Makertech3D/Dual-Switching-Hotend-v1/README.md

# Dual-Switching-Extruder
Downloads and opensource files for the Dual Switching Extruder
