Makertech3D/Dual-Switching-Hotend-v1/DSE Insert.pdf

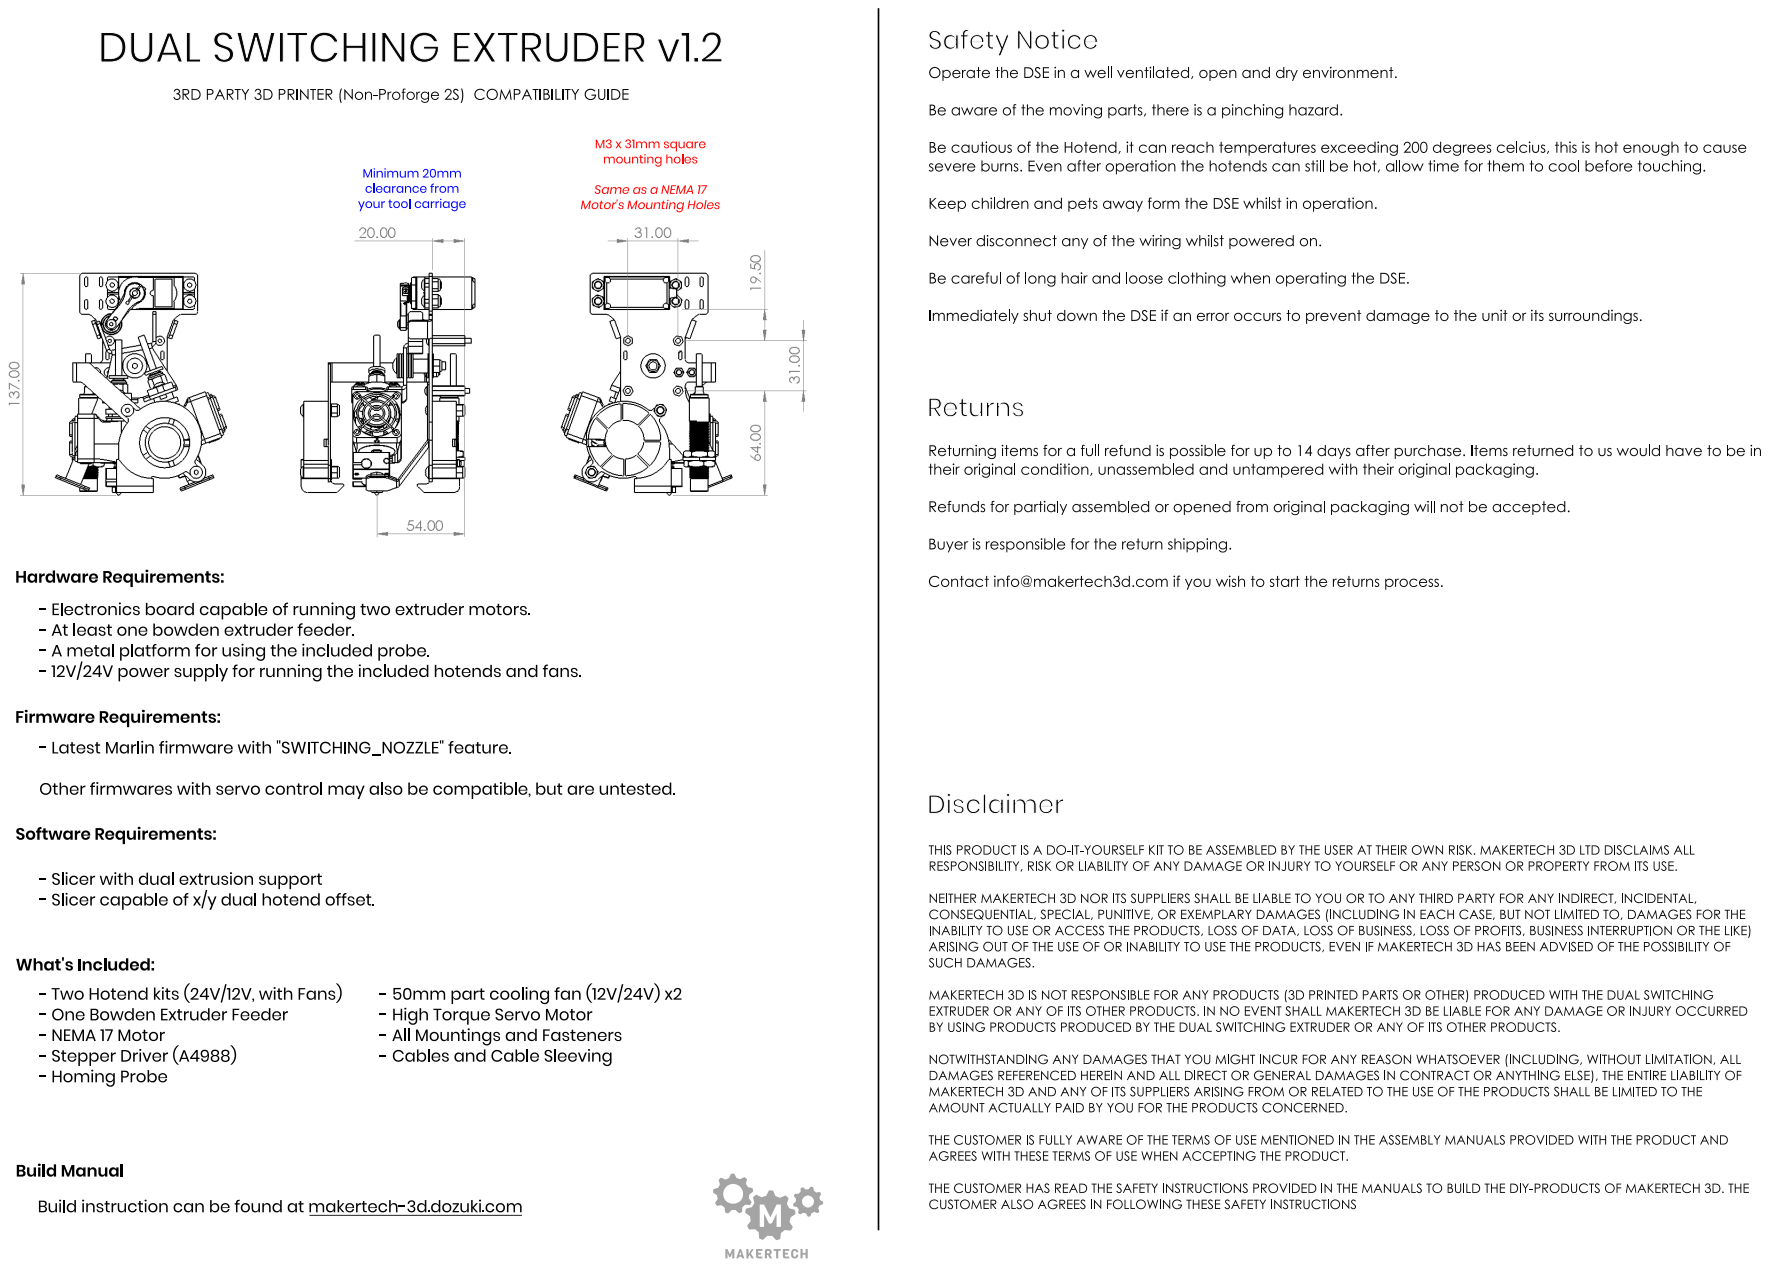
[picture p1: page 1]
