Makertech3D/Dual-Switching-Hotend-v1/3D Printed Parts/Fan Shroud Rear-Left (Raised).STL

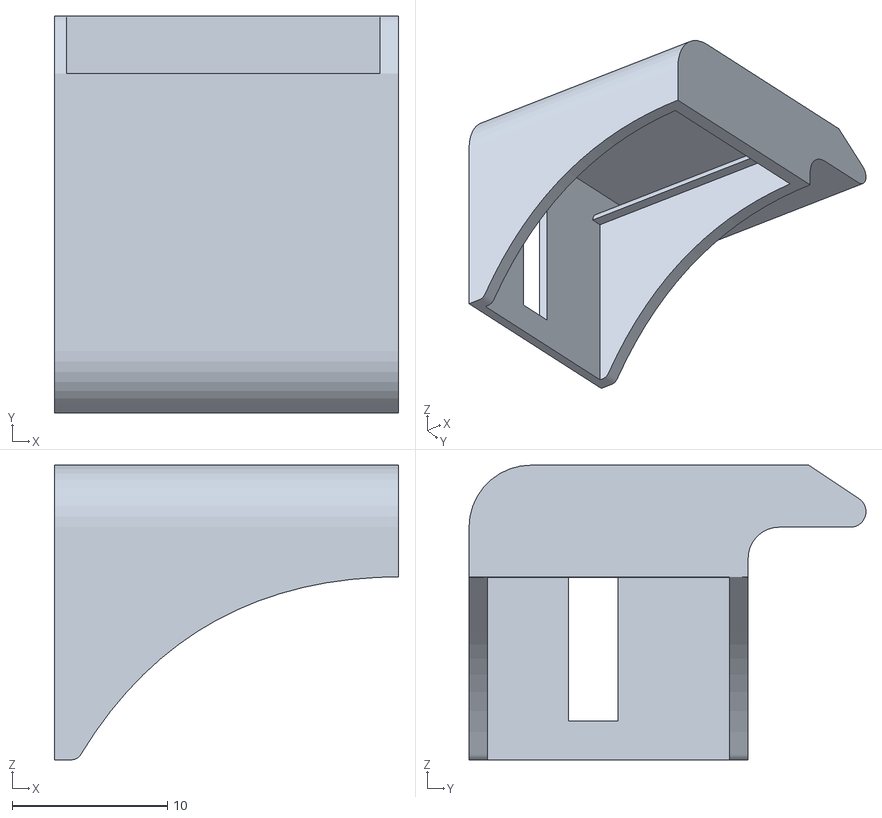
[picture p2: CAD file, 2020-07-07]
3D Printed Parts/Fan Shroud Rear-Left (Raised).STL
22.2 x 25.6 x 19.0
