Makertech3D/Dual-Switching-Hotend-v1/DSE Calibration Model/DSE Calibration Model (2).STL

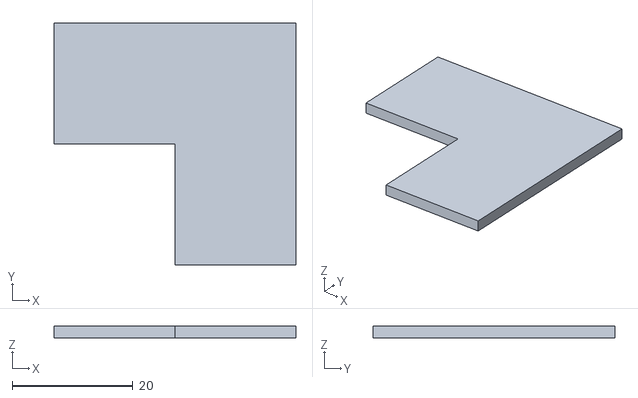
[picture p3: CAD file, 2020-07-07]
DSE Calibration Model/DSE Calibration Model (2).STL
40.0 x 40.0 x 2.00
