Makertech3D/Dual-Switching-Hotend-v1/DSE Metal Parts/DSE Hotend Mount.STEP

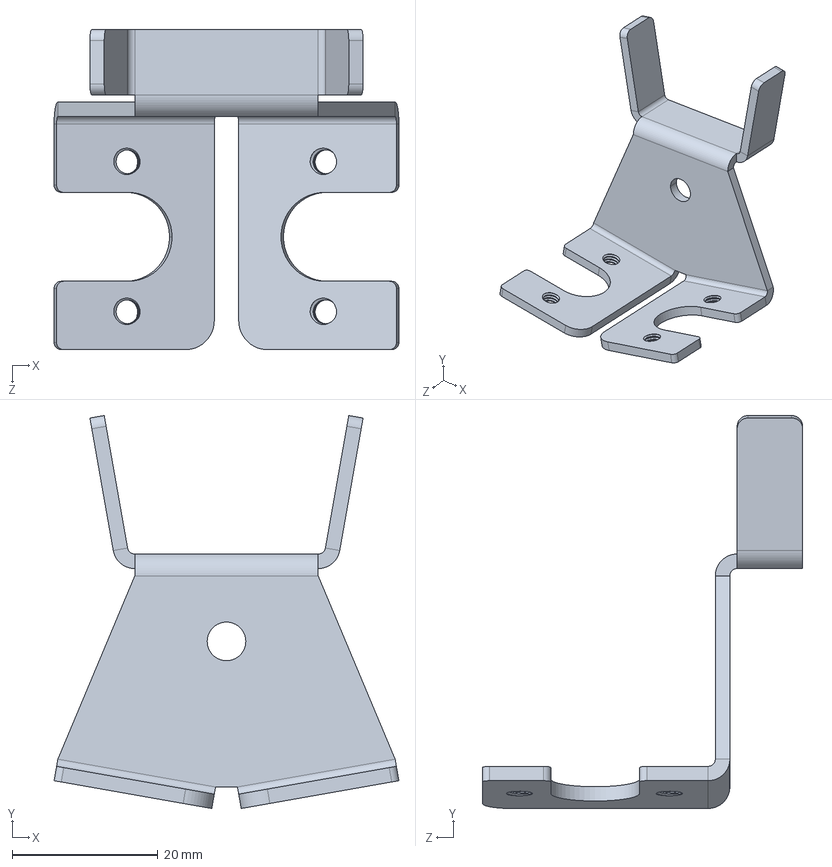
[picture p4: CAD file, 2020-07-07]
DSE Metal Parts/DSE Hotend Mount.STEP
47.4 x 54.0 x 44.0 mm
