Makertech3D/Dual-Switching-Hotend-v1/3D Printed Parts/Fan Shroud Front-Right (Raised).STL

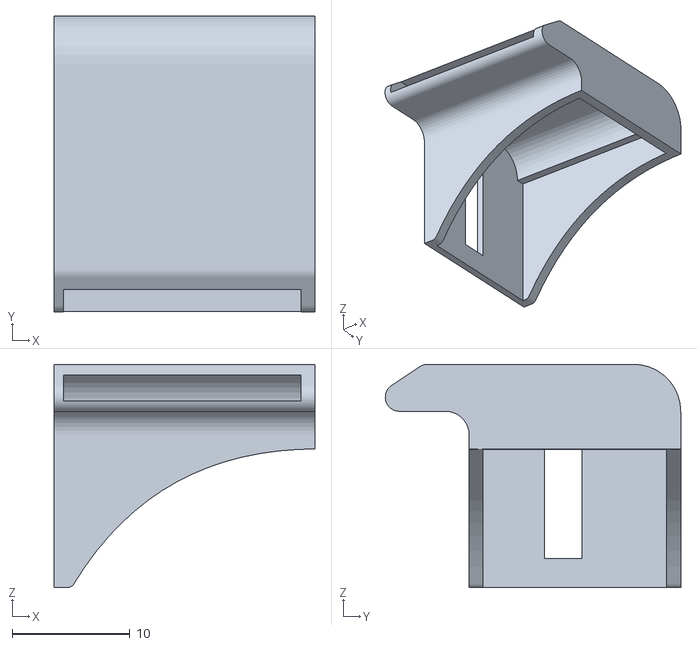
[picture p5: CAD file, 2020-07-07]
3D Printed Parts/Fan Shroud Front-Right (Raised).STL
22.2 x 25.1 x 19.0
