Makertech3D/Dual-Switching-Hotend-v1/DSE Metal Parts/Tool Carriage.STEP

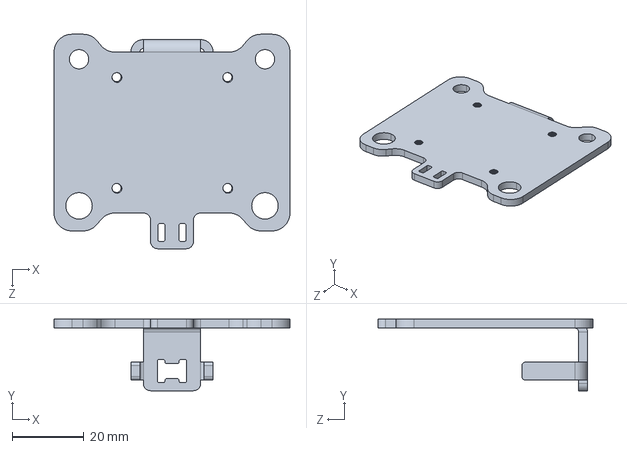
[picture p7: CAD file, 2020-07-07]
DSE Metal Parts/Tool Carriage.STEP
66.0 x 20.0 x 60.0 mm
