Makertech3D/Dual-Switching-Hotend-v1/DSE Metal Parts/DSE Back Plate.STEP

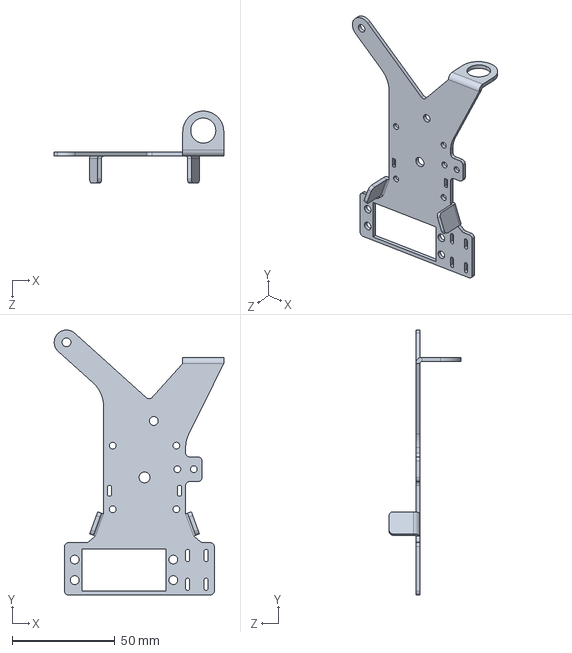
[picture p8: CAD file, 2020-07-07]
DSE Metal Parts/DSE Back Plate.STEP
82.6 x 129.0 x 35.0 mm
