Makertech3D/Dual-Switching-Hotend-v1/DSE Metal Parts/Ooze Shield.STEP

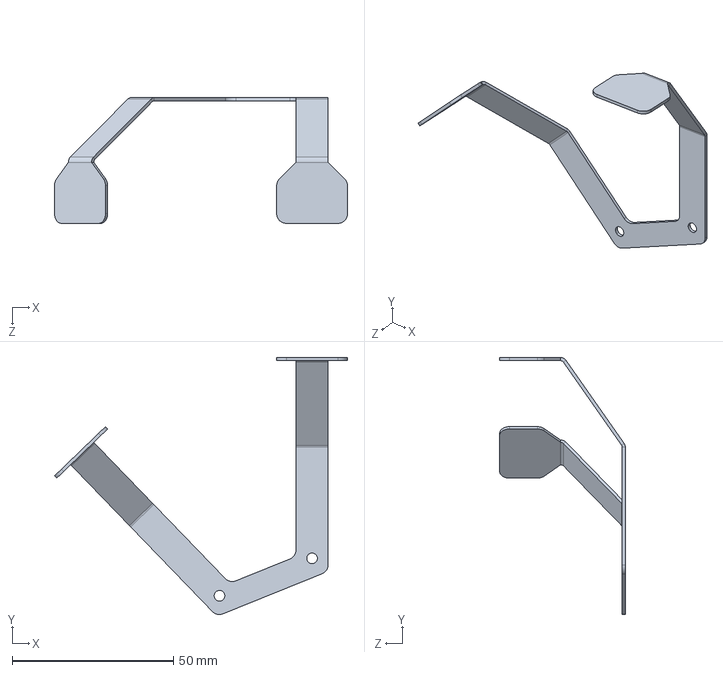
[picture p9: CAD file, 2020-07-07]
DSE Metal Parts/Ooze Shield.STEP
91.0 x 79.8 x 39.1 mm
