Makertech3D/Dual-Switching-Hotend-v1/DSE Metal Parts/2nd Fan Mount.STEP

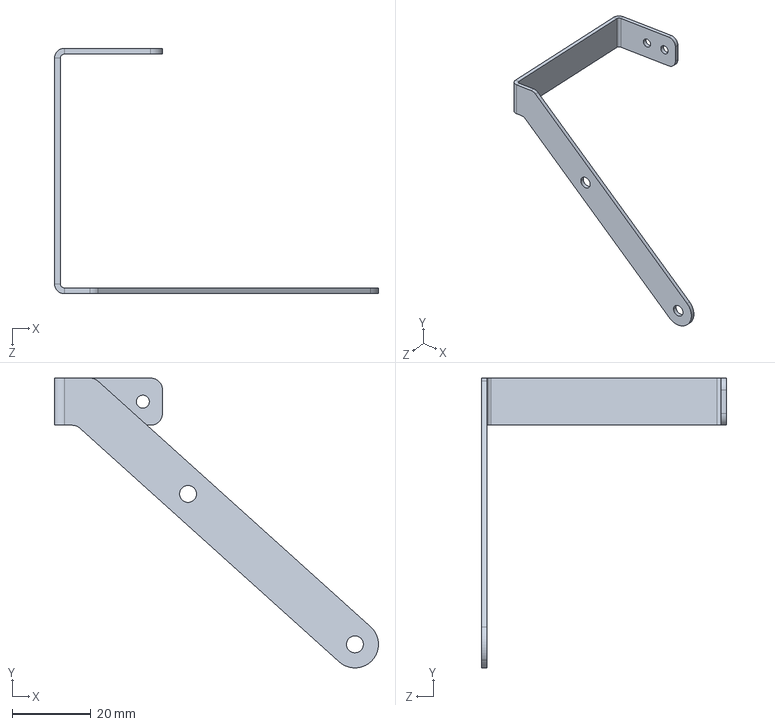
[picture p10: CAD file, 2020-07-07]
DSE Metal Parts/2nd Fan Mount.STEP
82.5 x 73.8 x 62.5 mm
