Makertech3D/Dual-Switching-Hotend-v1/DSE Metal Parts/Spool Holder.STEP

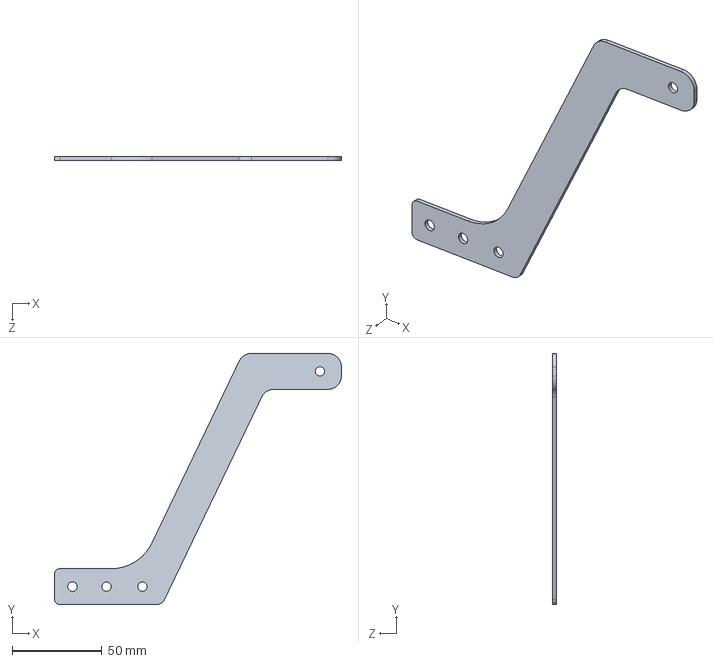
[picture p11: CAD file, 2020-07-07]
DSE Metal Parts/Spool Holder.STEP
160.0 x 140.0 x 2.00 mm
