Makertech3D/Dual-Switching-Hotend-v1/DSE Metal Parts/2nd Fan Mount.PDF

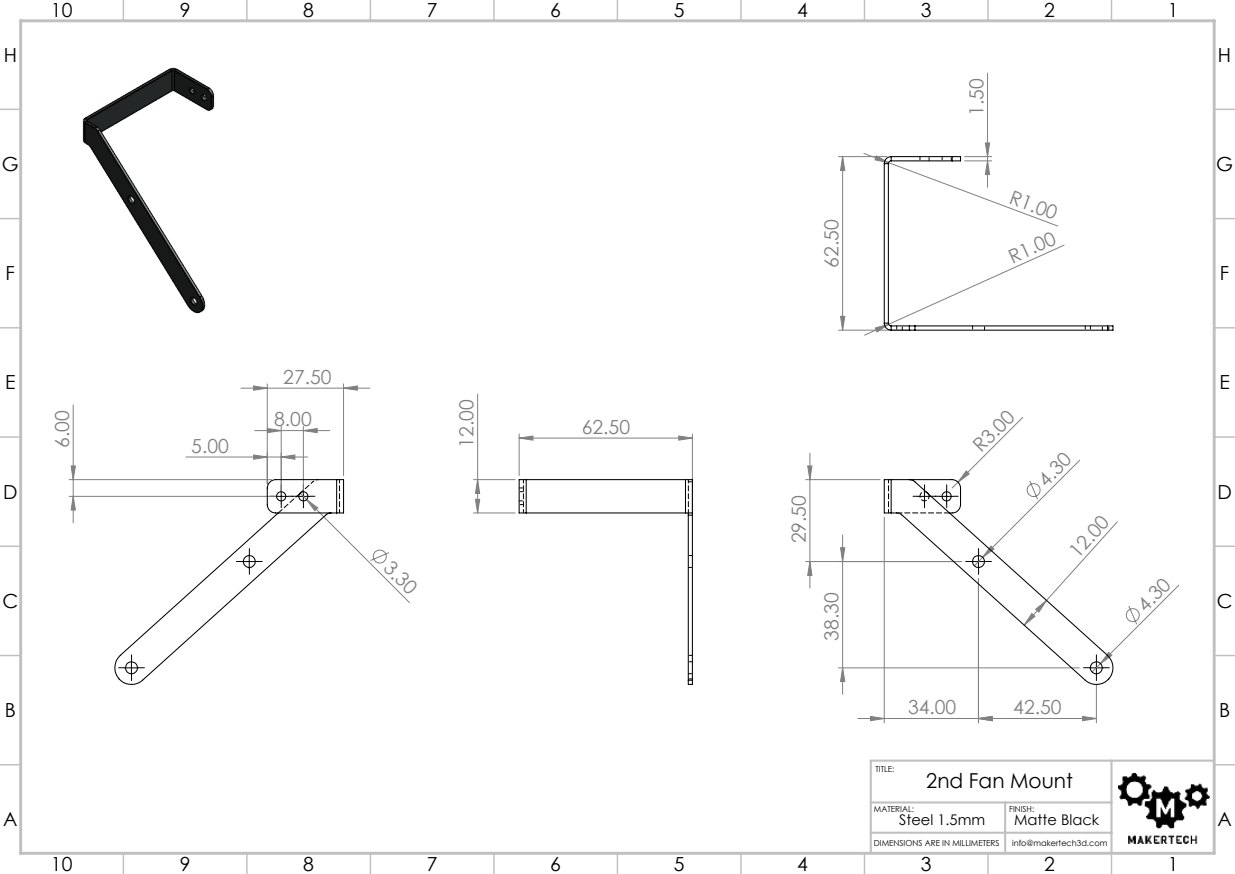
[picture p12: page 1]
Steel 1.5mm

TITLE: 2nd Fan Mount

MATERIAL: | FINISH: Matte Black

DIMENSIONS ARE IN MILLIMETERS | info@makertech3d.com
