Makertech3D/Dual-Switching-Hotend-v1/DSE Metal Parts/DSE Back Plate.PDF

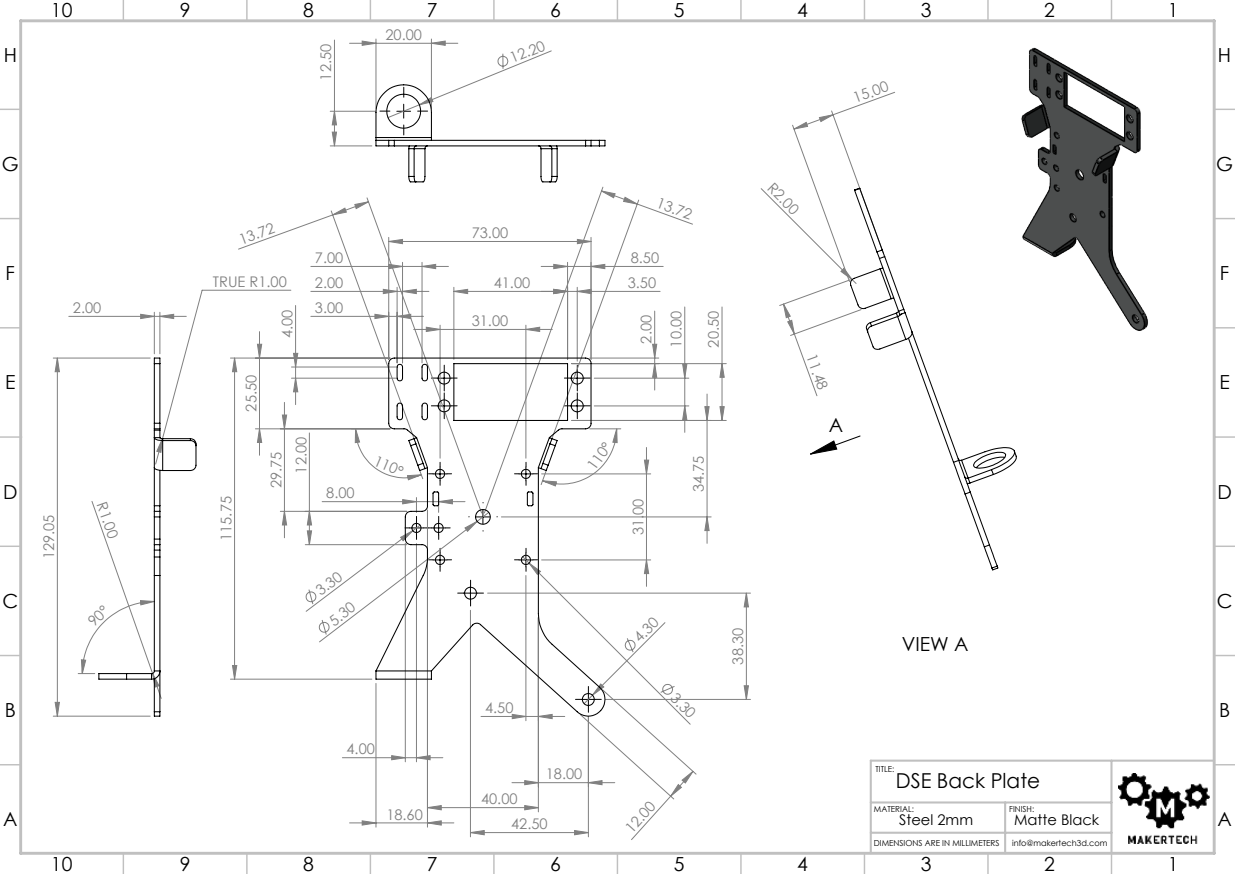
[picture p13: page 1]
TRUE R1.00; VIEW A; Steel 2mm

TITLE: DSE Back Plate

MATERIAL: | FINISH: Matte Black

DIMENSIONS ARE IN MILLIMETERS | info@makertech3d.com
