Makertech3D/Dual-Switching-Hotend-v1/DSE Metal Parts/DSE Hotend Mount.PDF

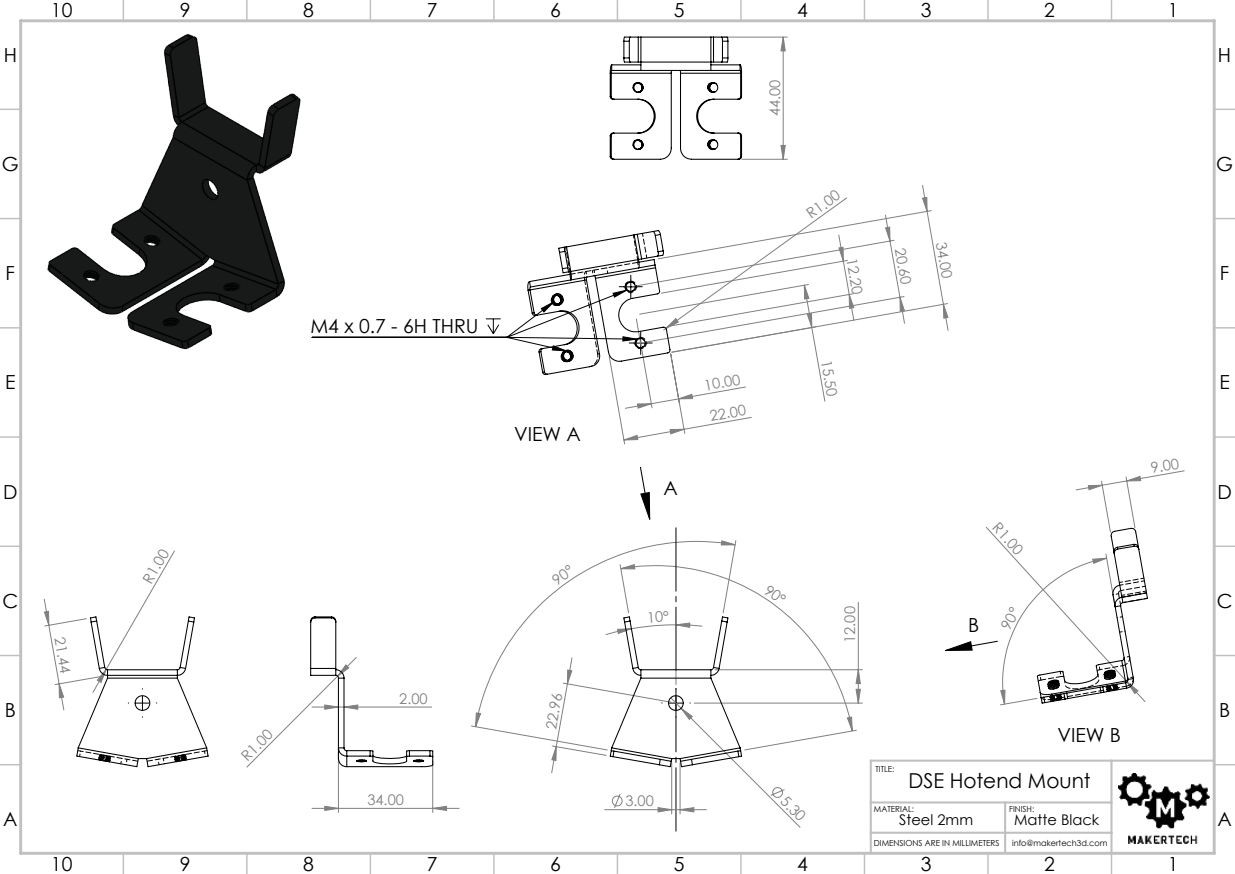
[picture p14: page 1]
VIEW B; VIEW A; M4 x 0.7 - 6H THRU; Steel 2mm; Matte Black

TITLE: DSE Hotend Mount

MATERIAL: | FINISH:

DIMENSIONS ARE IN MILLIMETERS | info@makertech3d.com
