Makertech3D/Dual-Switching-Hotend-v1/DSE Metal Parts/Ooze Shield.PDF

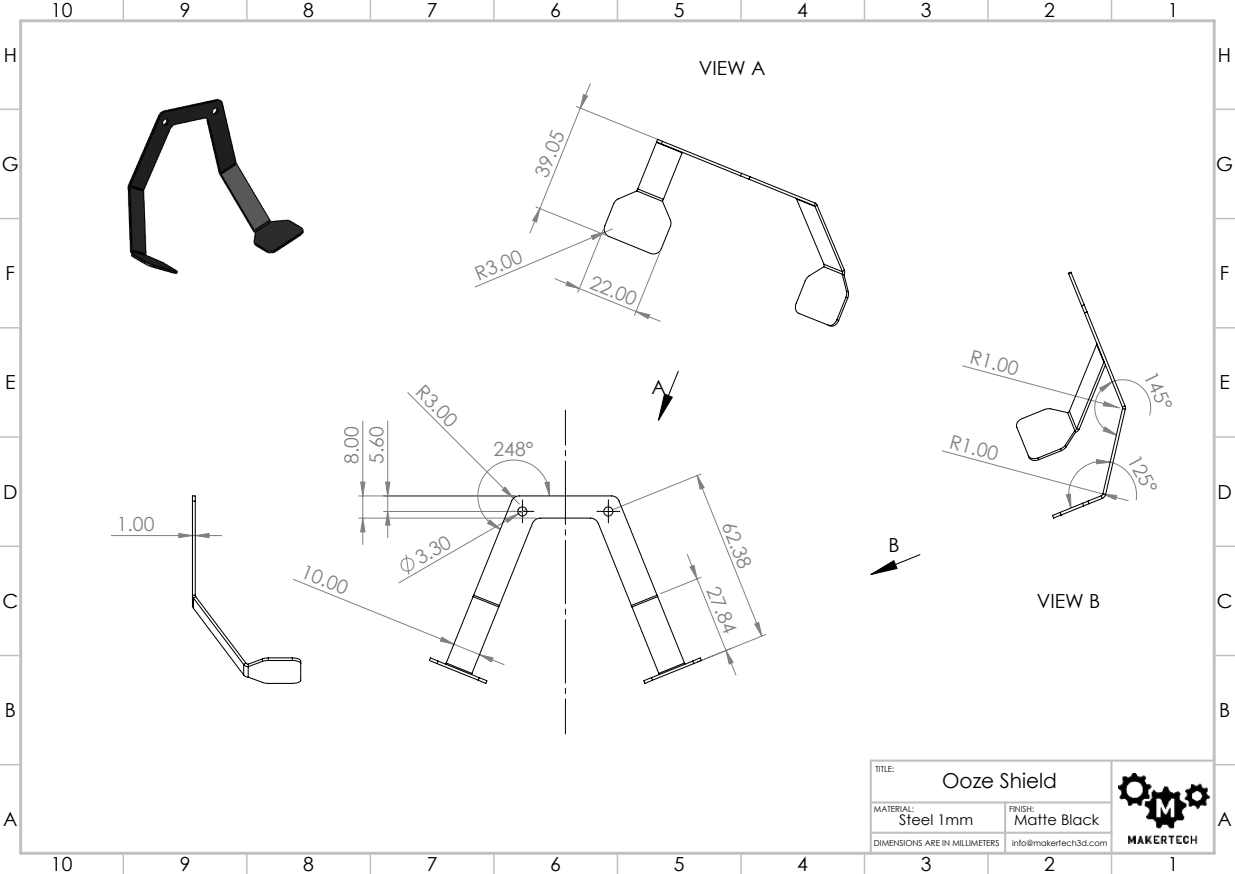
[picture p15: page 1]
VIEW A; VIEW B; Steel 1mm

TITLE: Ooze Shield

MATERIAL: | FINISH: Matte Black

DIMENSIONS ARE IN MILLIMETERS | info@makertech3d.com
