Makertech3D/Dual-Switching-Hotend-v1/DSE Metal Parts/Spool Holder.PDF

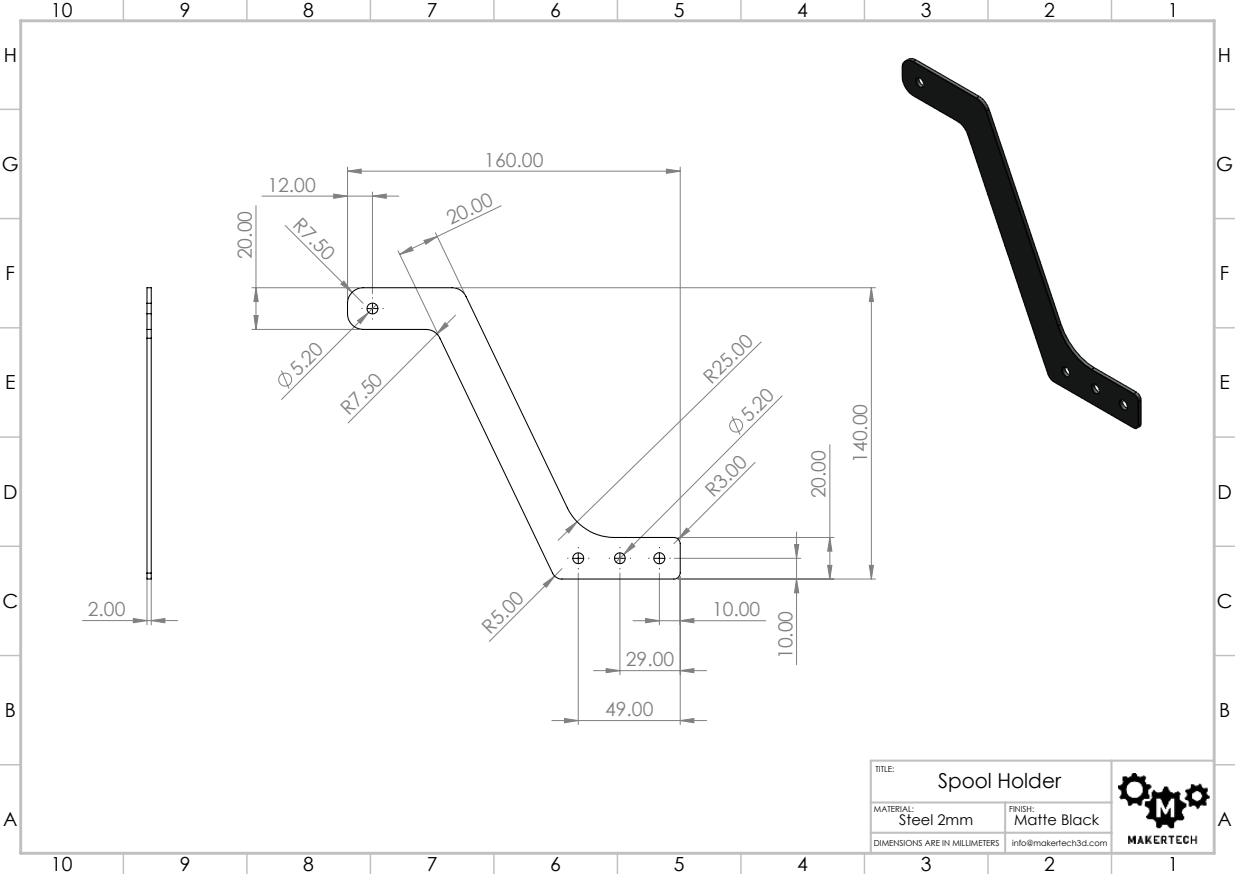
[picture p16: page 1]
Steel 2mm

TITLE: Spool Holder

MATERIAL: | FINISH: Matte Black

DIMENSIONS ARE IN MILLIMETERS | info@makertech3d.com
