Makertech3D/Dual-Switching-Hotend-v1/DSE Metal Parts/Tool Carriage.PDF

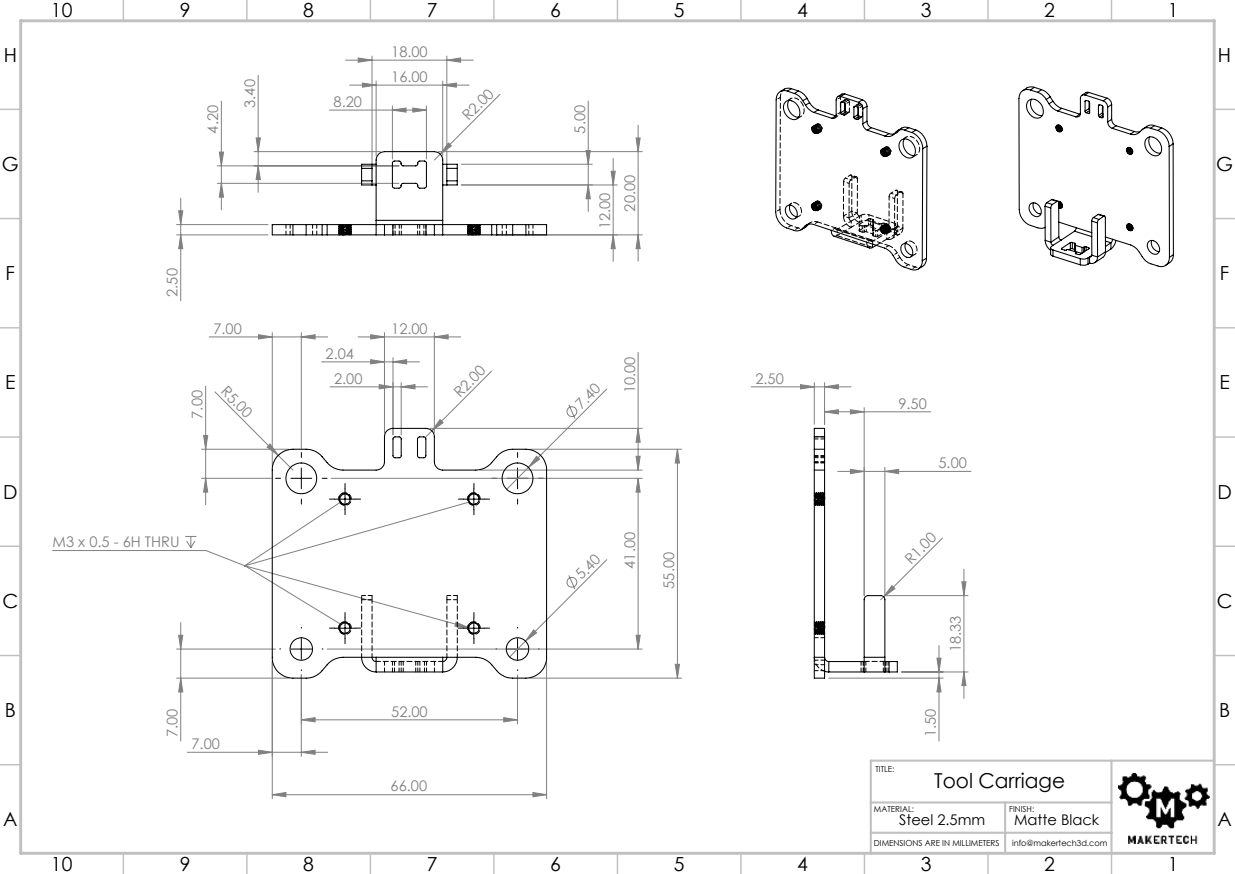
[picture p17: page 1]
M3 x 0.5 - 6H THRU; Steel 2.5mm

TITLE: Tool Carriage

MATERIAL: | FINISH: Matte Black

DIMENSIONS ARE IN MILLIMETERS | info@makertech3d.com
