Makertech3D/Dual-Switching-Hotend-v1/DSE Cables/Fan Adapter Cable.PDF

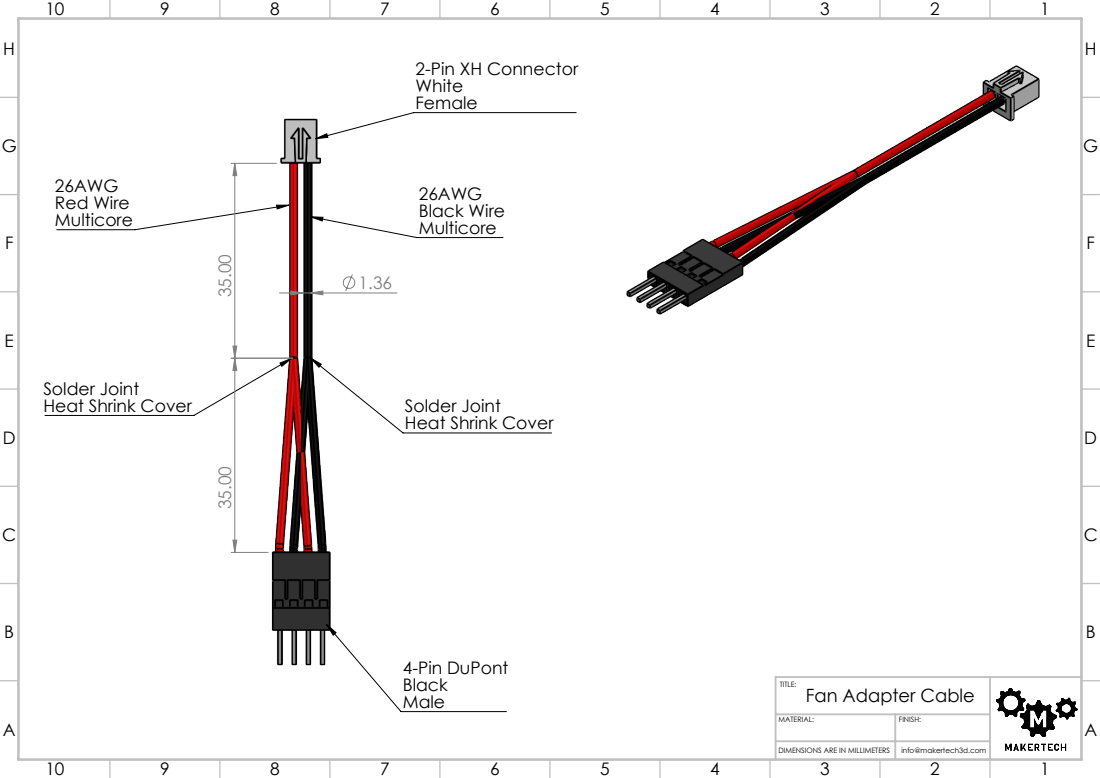
[picture p18: page 1]
Red Wire; Black Wire; Solder Joint; Heat Shrink Cover; 4-Pin DuPont

2-Pin XH Connector
White
Female

Heat Shrink Cover

TITLE: Fan Adapter Cable

MATERIAL: | FINISH:

DIMENSIONS ARE IN MILLIMETERS | info@makertech3d.com
