Makertech3D/Dual-Switching-Hotend-v1/DSE Cables/LJ12A3-4-Z-BY Probe Wired.PDF

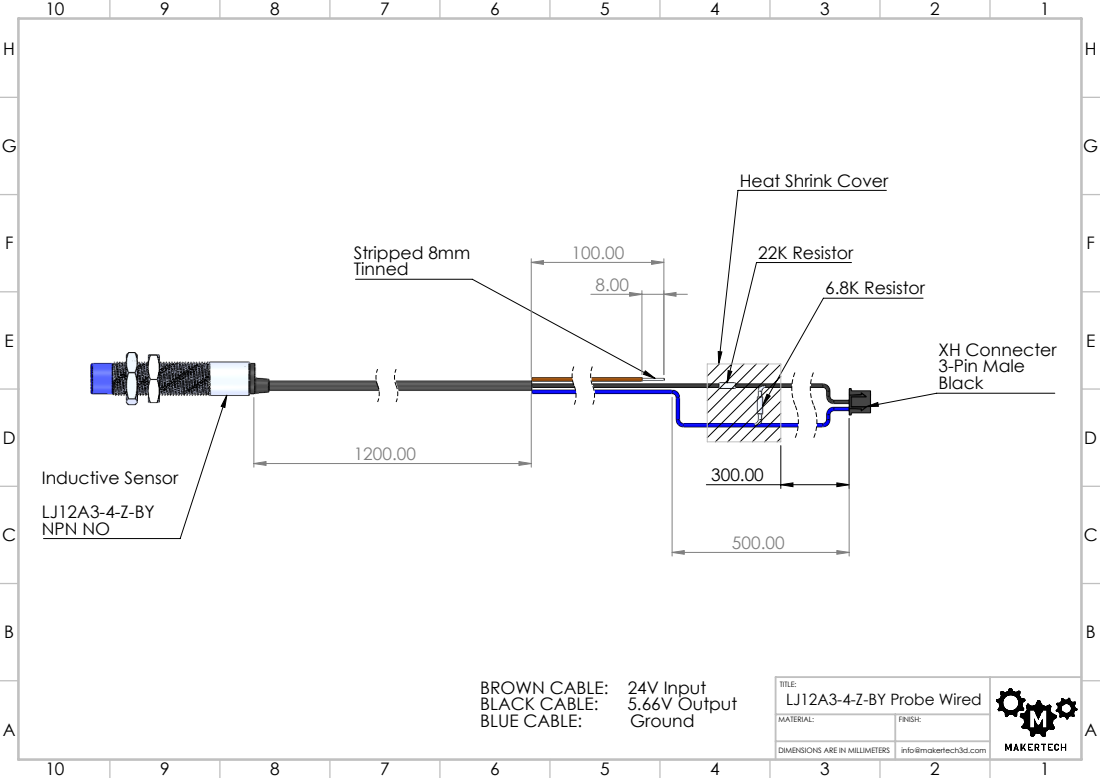
[picture p19: page 1]
XH Connecter 3-Pin Male; Stripped 8mm; Inductive Sensor; NPN NO; 22K Resistor; 6.8K Resistor; BLACK CABLE:; 5.66V Output; BLUE CABLE:; Ground

Heat Shrink Cover

BROWN CABLE: 24V Input

TITLE: LJ12A3-4-Z-BY Probe Wired

MATERIAL: | FINISH:

DIMENSIONS ARE IN MILLIMETERS | info@makertech3d.com
