Makertech3D/Dual-Switching-Hotend-v1/DSE Cables/Servo Cable.PDF

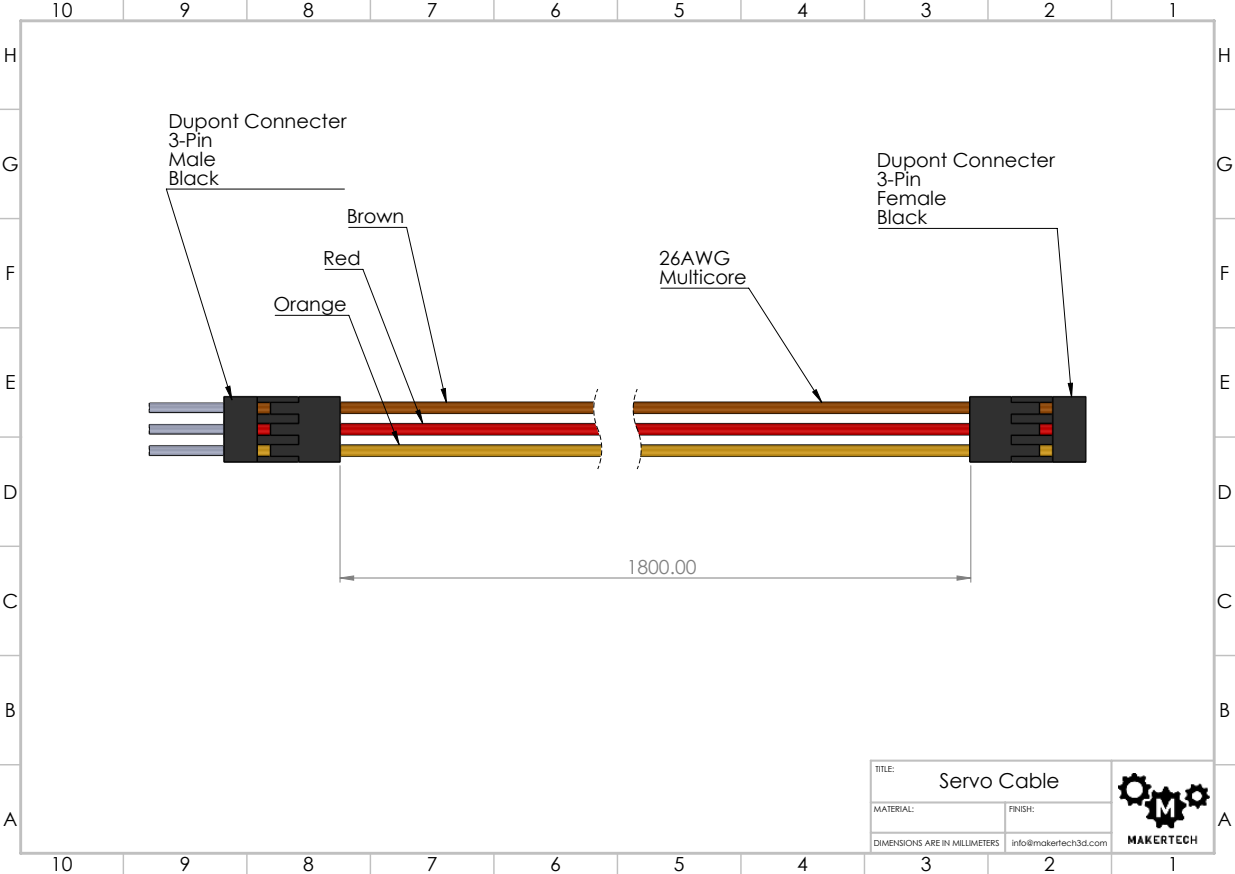
[picture p20: page 1]
Dupont Connecter

TITLE: Servo Cable

MATERIAL: | FINISH:

DIMENSIONS ARE IN MILLIMETERS | info@makertech3d.com
