Makertech3D/Dual-Switching-Hotend-v1/(commit log)

2020-07-07 DSE Files
    [2nd Fan Mount.STEP, DSE Back Plate.STEP, DSE Calibration Model (1).STL, DSE Calibration Model (2).STL, DSE Hotend Mount.STEP, Fan Shroud Front-Right (Raised).STL, Fan Shroud Rear-Left (Raised).STL, Ooze Shield.STEP]
2020-07-14 Create Dual Switching Extruder.STEP
